KrystianRuszczak/BioSense/hardware/biosense_pcb/README.md

# BioSense PCB

## Main modules
- ESP32 / ESP32-S3
- AD8232 ECG
- GSR input
- MLX90614
- MAX30102
- battery measurement
- buzzer
- push buttons
- WS2812 LEDs

## Firmware pin mapping
See `main/include/biosense_config.hpp`.

## Fabrication
Production files for ordered revisions are stored in `fabrication/revX/`.

## License

Copyright (c) 2026 Krystian Ruszczak.

The hardware design files in this directory are licensed under CERN-OHL-P-2.0. See [LICENSE](LICENSE).

The design files are provided "as is", without warranty. The complete terms are in the license file.
