KrystianRuszczak/BioSense/hardware/biosense_pcb/Biosense.kicad_pcb

## KiCad design hardware/biosense_pcb/Biosense.kicad_pcb (2026-07-09)

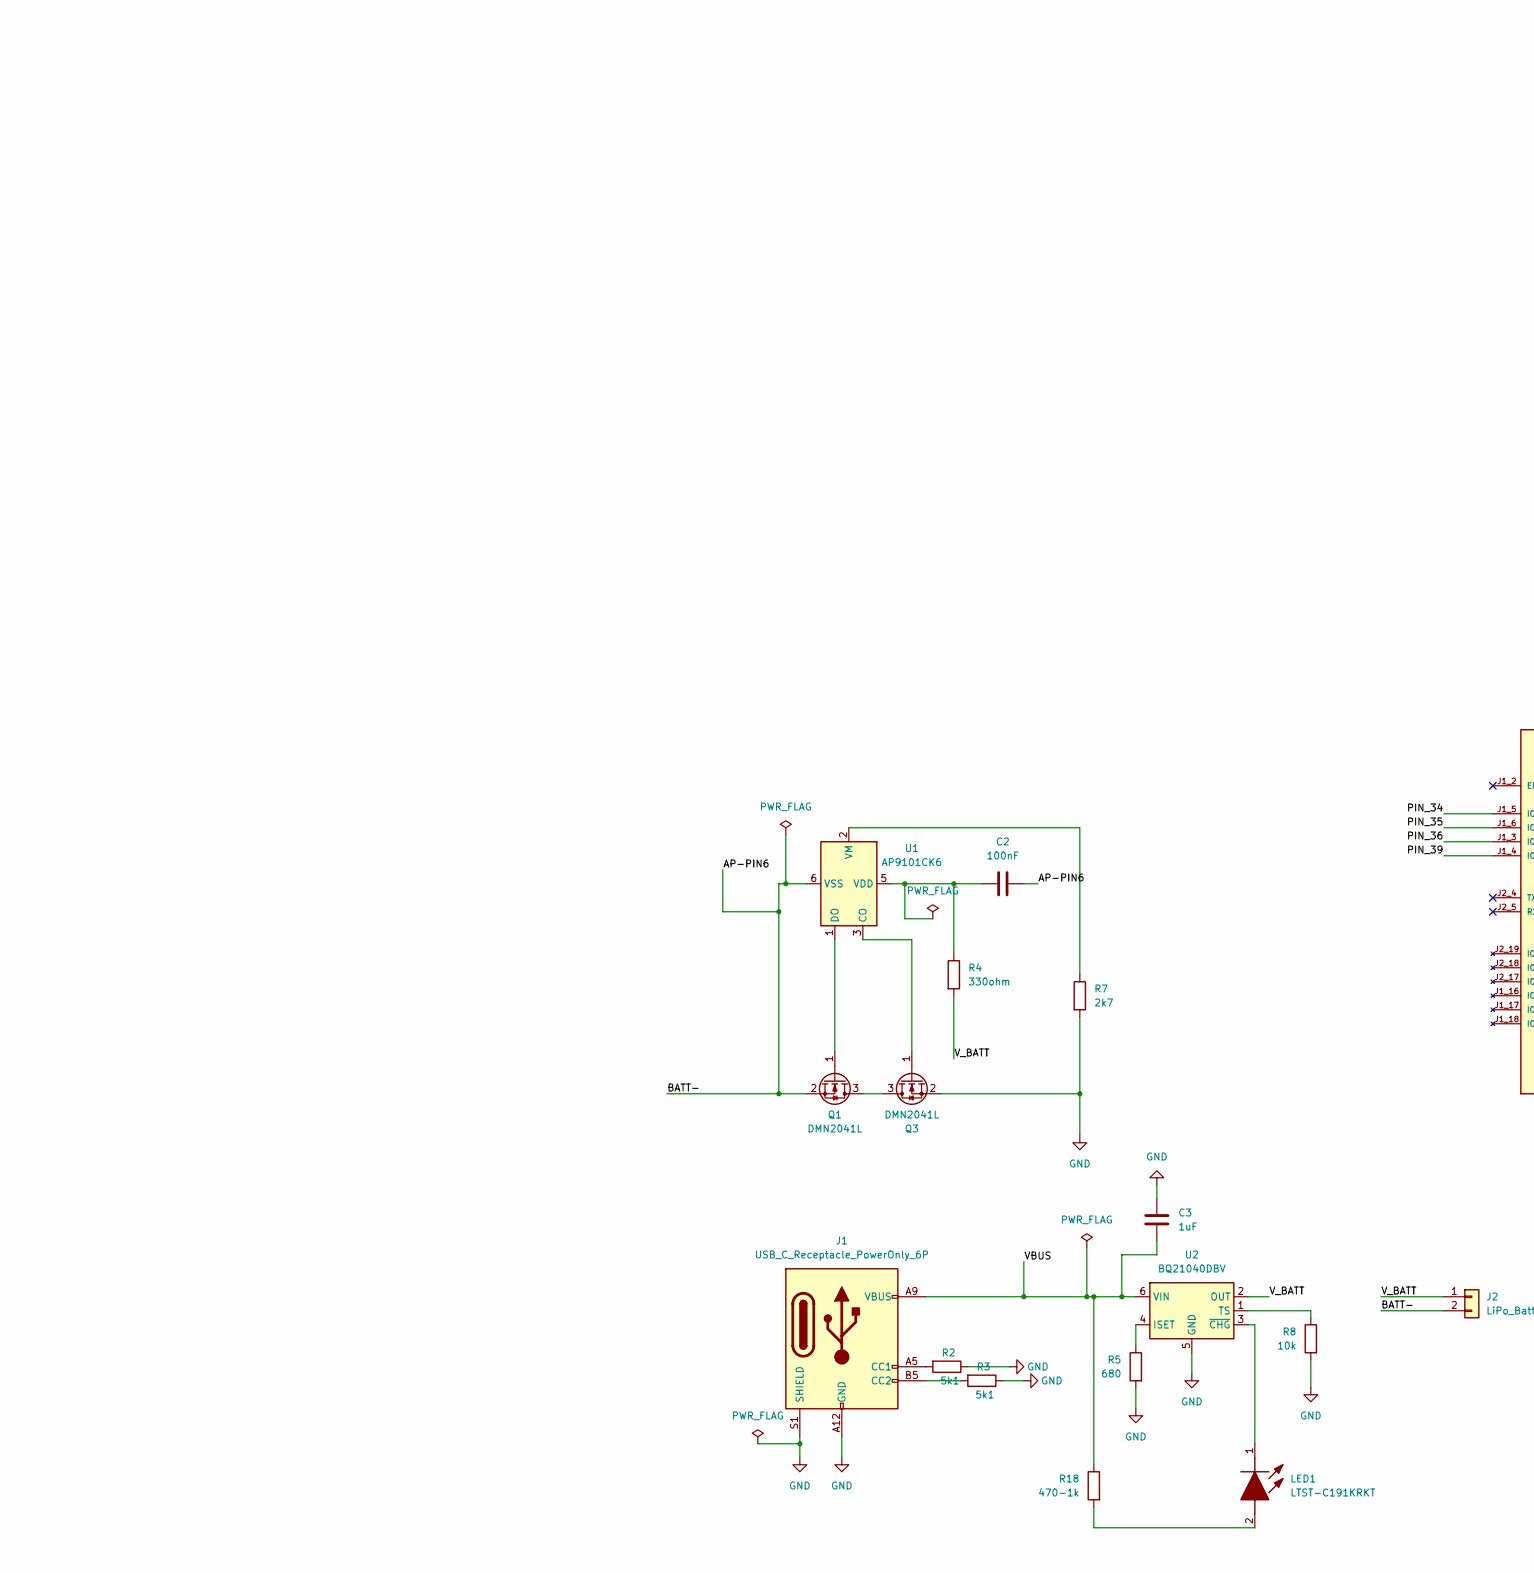
[picture p1: schematic Biosense.kicad_sch, part in row 1, column 1]

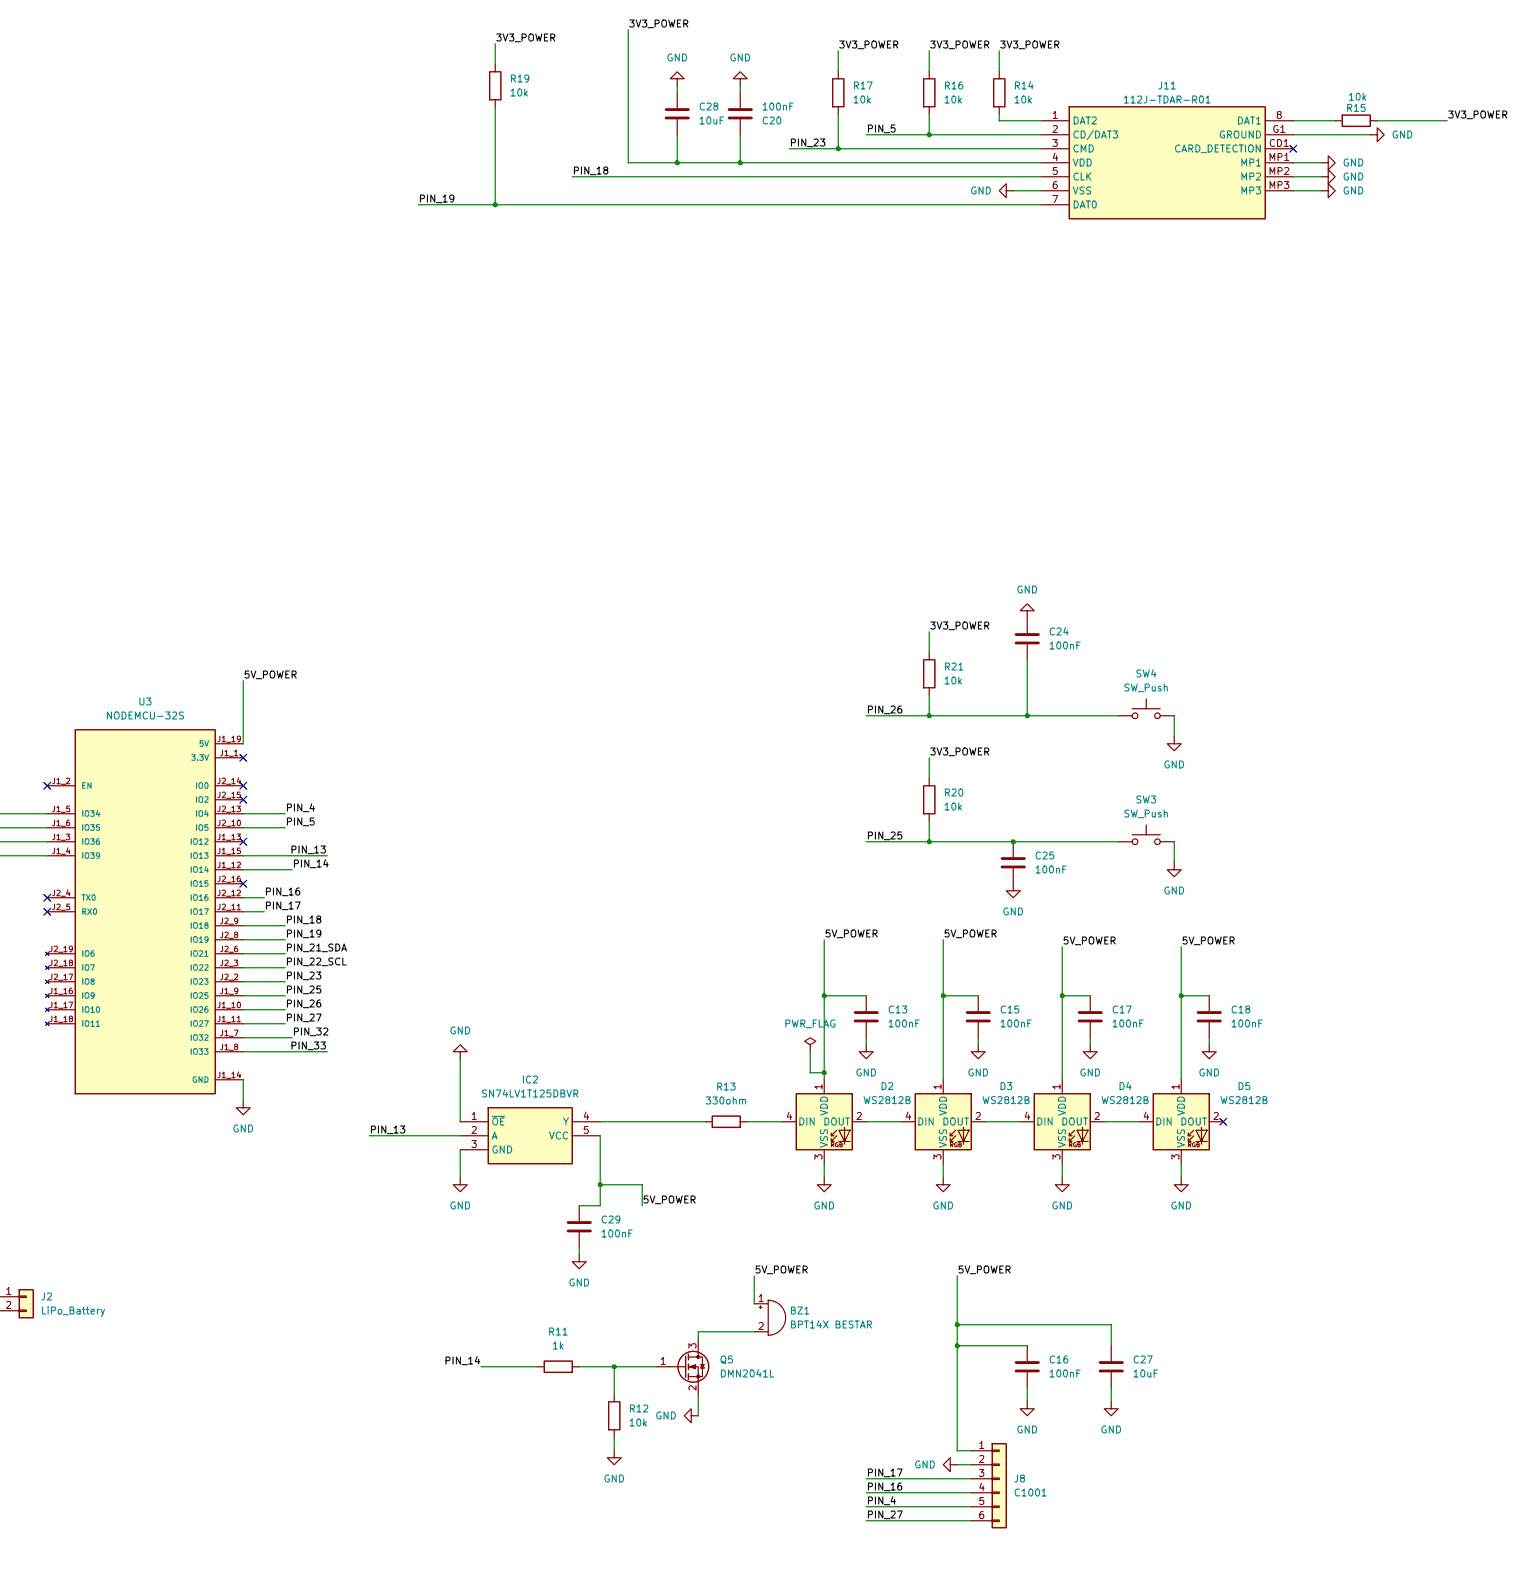
[picture p2: schematic Biosense.kicad_sch, part in row 1, column 2]

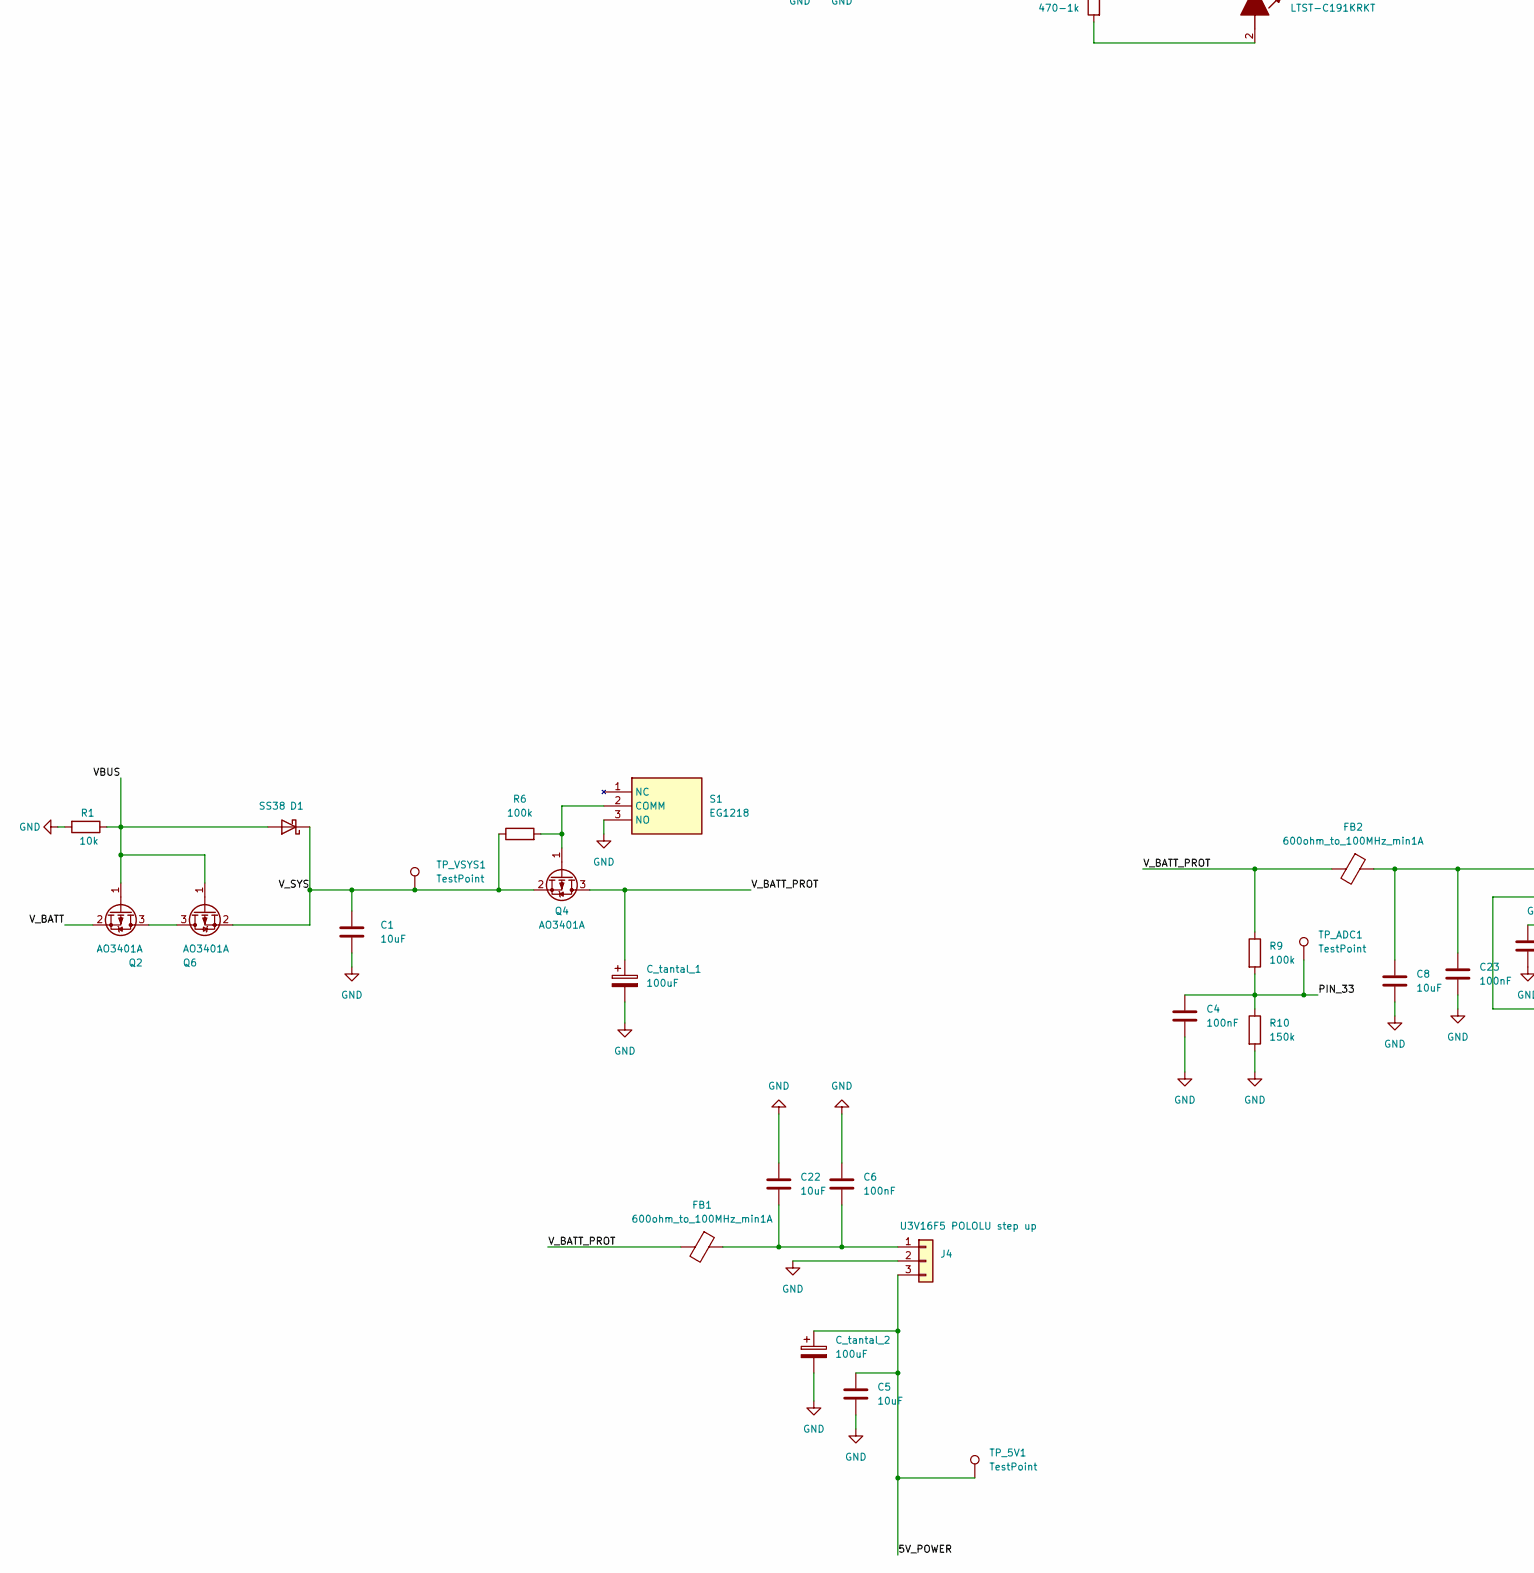
[picture p3: schematic Biosense.kicad_sch, part in row 2, column 1]

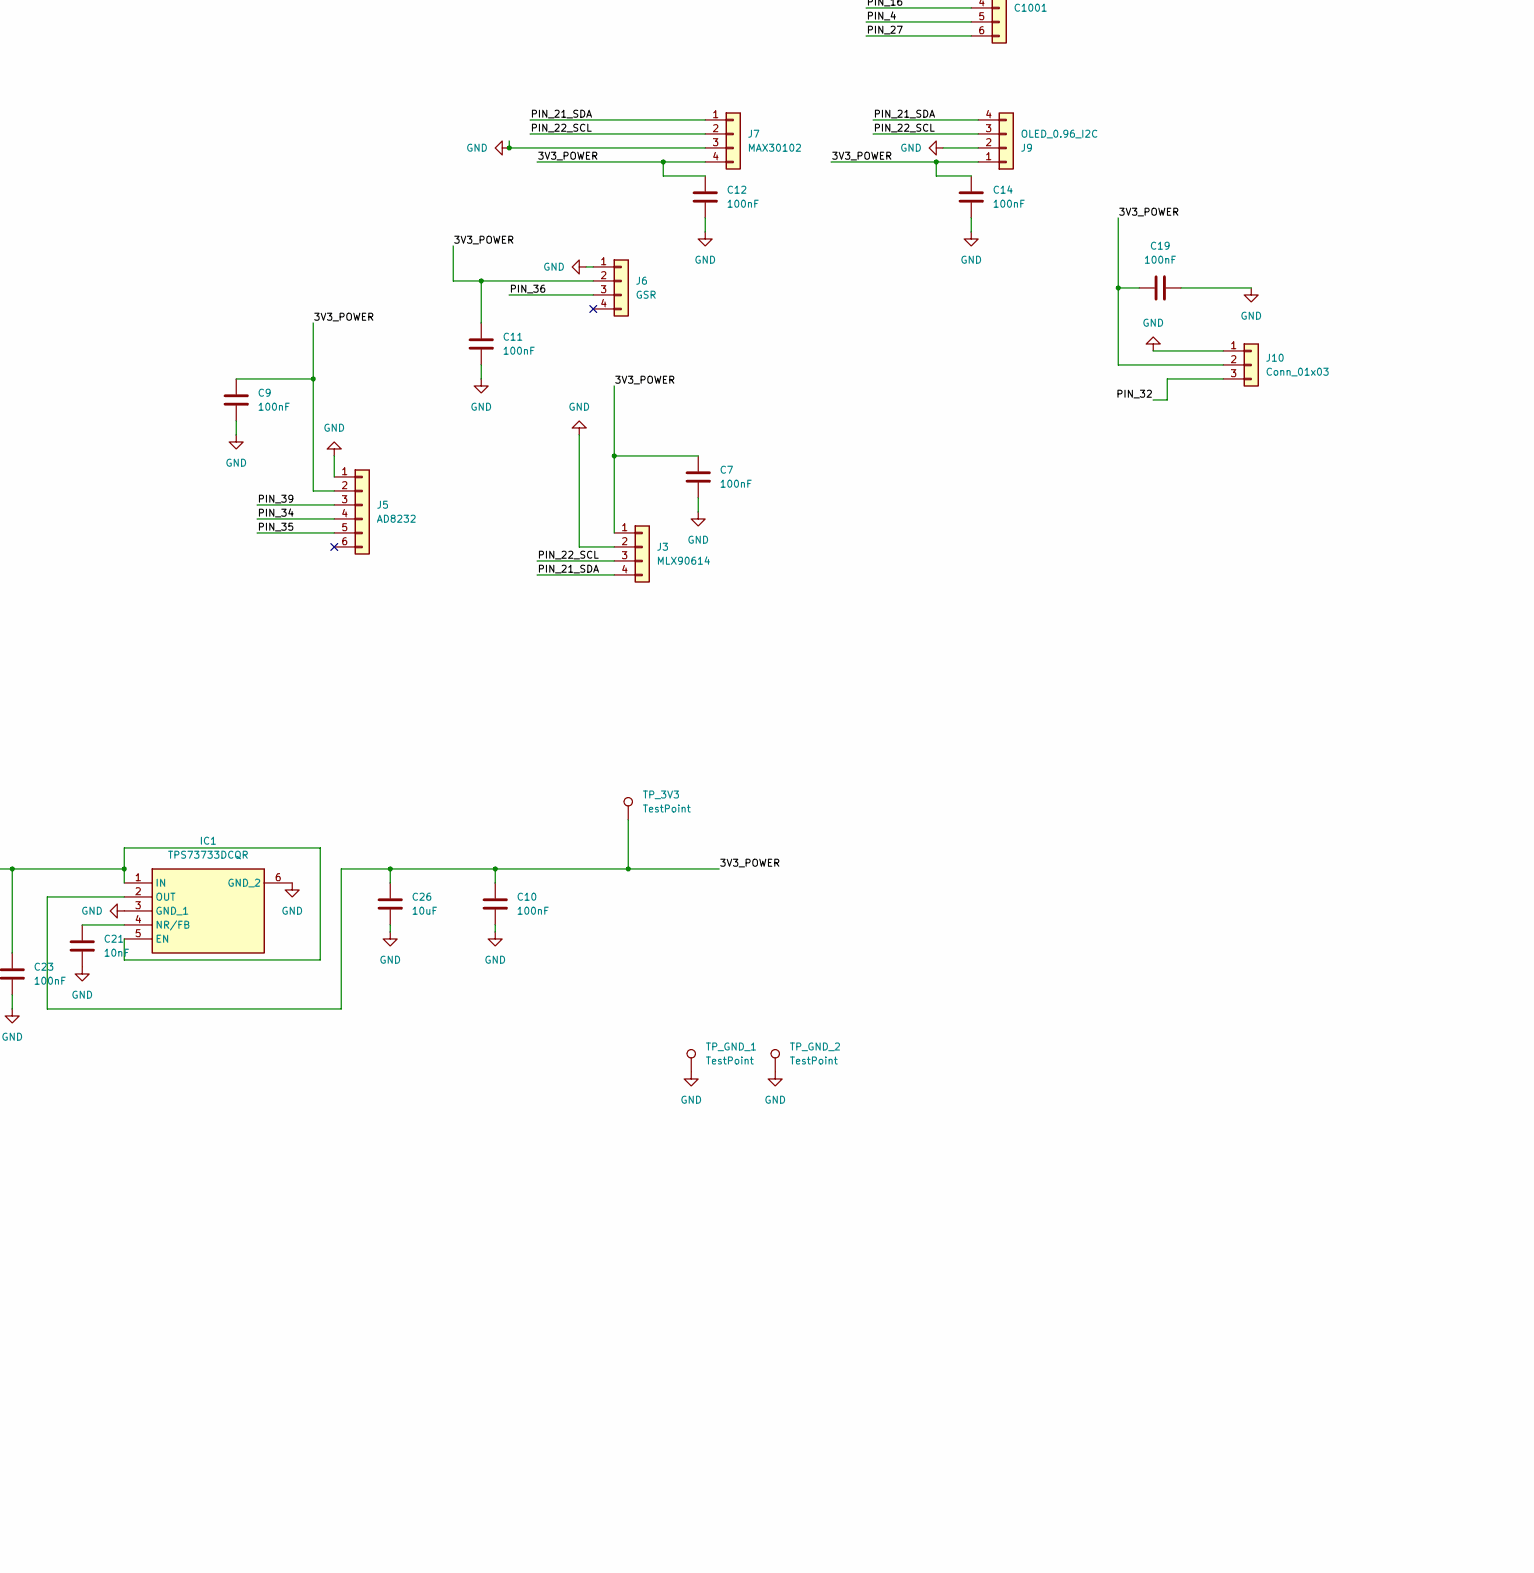
[picture p4: schematic Biosense.kicad_sch, part in row 2, column 2]

Parts:
BZ1: BPT14X BESTAR; Buzzer_15x7.5RM7.6
C1, C5, C8, C22, C26, C27, C28: 10uF; C_0805_2012Metric_Pad1.18x1.45mm_HandSolder
C2, C4, C6, C7, C9, C10, C11, C12, C13, C14, C15, C16, C17, C18, C19, C20, C23, C24, C25, C29: 100nF; C_0805_2012Metric_Pad1.18x1.45mm_HandSolder
C3: 1uF; C_0805_2012Metric_Pad1.18x1.45mm_HandSolder
C21: 10nF; C_0805_2012Metric_Pad1.18x1.45mm_HandSolder
C_tantal_1, C_tantal_2: 100uF; CP_EIA-7343-31_Kemet-D_HandSolder
D1: SS38; D_SMA_Handsoldering
D2, D3, D4, D5: WS2812B; LED_WS2812B_PLCC4_5.0x5.0mm_P3.2mm
FB1, FB2: 600ohm_to_100MHz_min1A; R_0805_2012Metric_Pad1.20x1.40mm_HandSolder
IC1: TPS73733DCQR; SOT127P706X180-6N; Manufacturer_Part_Number TPS73733DCQR
IC2: SN74LV1T125DBVR; SOT-23-5_HandSoldering; Manufacturer_Part_Number SN74LV1T125DBVR
J1: USB_C_Receptacle_PowerOnly_6P; USB_C_Receptacle_GCT_USB4125-xx-x-0190_6P_TopMnt_Horizontal
J2: LiPo_Battery; JST_XH_B2B-XH-A_1x02_P2.50mm_Vertical
J3: MLX90614; PinHeader_1x04_P2.54mm_Vertical
J4: U3V16F5 POLOLU step up; PinSocket_1x03_P2.54mm_Vertical
J5: AD8232; PinHeader_1x06_P2.54mm_Vertical
J6: GSR; PinHeader_1x04_P2.54mm_Vertical
J7: MAX30102; PinHeader_1x04_P2.54mm_Vertical
J8: C1001; PinHeader_1x06_P2.54mm_Vertical
J9: OLED_0.96_I2C; PinHeader_1x04_P2.54mm_Vertical
J10: Conn_01x03; PinHeader_1x03_P2.54mm_Vertical
J11: 112J-TDAR-R01; 112JTDARR01; Manufacturer_Part_Number 112J-TDAR-R01
LED1: LTST-C191KRKT; LEDC1608X55N; Manufacturer_Part_Number LTST-C191KRKT
Q1, Q3, Q5: DMN2041L; SOT-23_Handsoldering
Q2, Q4, Q6: AO3401A; SOT-23_Handsoldering
R1, R8, R12, R14, R15, R16, R17, R19, R20, R21: 10k; R_0805_2012Metric_Pad1.20x1.40mm_HandSolder
R2, R3: 5k1; R_0805_2012Metric_Pad1.20x1.40mm_HandSolder
R4, R13: 330ohm; R_0805_2012Metric_Pad1.20x1.40mm_HandSolder
R5: 680; R_0805_2012Metric_Pad1.20x1.40mm_HandSolder
R6, R9: 100k; R_0805_2012Metric_Pad1.20x1.40mm_HandSolder
R7: 2k7; R_0805_2012Metric_Pad1.20x1.40mm_HandSolder
R10: 150k; R_0805_2012Metric_Pad1.20x1.40mm_HandSolder
R11: 1k; R_0805_2012Metric_Pad1.20x1.40mm_HandSolder
R18: 470-1k; R_0805_2012Metric_Pad1.20x1.40mm_HandSolder
S1: EG1218; Manufacturer_Part_Number EG1218
SW3, SW4: SW_Push; SW_PUSH_6mm
TP_3V3, TP_5V1: TestPoint; TestPoint_Pad_D1.5mm
TP_ADC1: TestPoint; TestPoint_Pad_D1.5mm
TP_GND_1, TP_GND_2: TestPoint; TestPoint_THTPad_D2.0mm_Drill1.0mm
TP_VSYS1: TestPoint; TestPoint_Pad_D1.5mm
U1: AP9101CK6; SOT-23-6_Handsoldering
U2: BQ21040DBV; SOT-23-6_Handsoldering
U3: NODEMCU-32S; MODULE_NODEMCU-32S; PARTREV V1

Connections:
/3V3_POWER: C7.1, C9.1, C10.1, C11.1, C12.1, C14.1, C19.2, C20.1, C26.1, C28.2, IC1.2 (OUT), J3.1, J5.2, J6.2, J7.4, J9.1, J10.2, J11.4 (VDD), R14.1, R15.1, R16.1, R17.1, R19.1, R20.1, R21.1, TP_3V3.1 (1_1)
/5V_POWER: BZ1.1 (+), C5.1, C13.1, C15.1, C16.1, C17.1, C18.1, C27.1, C29.1, C_tantal_2.1, D2.1 (VDD), D3.1 (VDD), D4.1 (VDD), D5.1 (VDD), IC2.5 (VCC), J4.3, J8.1, TP_5V1.1 (1_1), U3.J1_19 (5V)
/AP-PIN6: C2.2, J2.2, Q1.2 (S), U1.6 (VSS)
/PIN_4: J8.5, U3.J2_13 (IO4)
/PIN_5: J11.2 (CD/DAT3), R16.2, U3.J2_10 (IO5)
/PIN_13: IC2.2 (A), U3.J1_15 (IO13)
/PIN_14: R11.1, U3.J1_12 (IO14)
/PIN_16: J8.4, U3.J2_12 (IO16)
/PIN_17: J8.3, U3.J2_11 (IO17)
/PIN_18: J11.5 (CLK), U3.J2_9 (IO18)
/PIN_19: J11.7 (DAT0), R19.2, U3.J2_8 (IO19)
/PIN_21_SDA: J3.4, J7.1, J9.4, U3.J2_6 (IO21)
/PIN_22_SCL: J3.3, J7.2, J9.3, U3.J2_3 (IO22)
/PIN_23: J11.3 (CMD), R17.2, U3.J2_2 (IO23)
/PIN_25: C25.1, R20.2, SW3.1, U3.J1_9 (IO25)
/PIN_26: C24.2, R21.2, SW4.1, U3.J1_10 (IO26)
/PIN_27: J8.6, U3.J1_11 (IO27)
/PIN_32: J10.3, U3.J1_7 (IO32)
/PIN_33: C4.1, R9.2, R10.1, TP_ADC1.1 (1_1), U3.J1_8 (IO33)
/PIN_34: J5.4, U3.J1_5 (IO34)
/PIN_35: J5.5, U3.J1_6 (IO35)
/PIN_36: J6.3, U3.J1_3 (IO36)
/PIN_39: J5.3, U3.J1_4 (IO39)
/VBUS: C3.2, D1.2 (A), J1.A9 (VBUS), J1.B9 (VBUS), Q2.1 (G), Q6.1 (G), R1.1, R18.1, U2.6 (VIN)
/V_BATT: J2.1, Q2.2 (S), R4.2, U2.2 (OUT)
/V_BATT_PROT: C_tantal_1.1, FB1.2, FB2.2, Q4.3 (D), R9.1
/V_SYS: C1.1, D1.1 (K), Q4.2 (S), Q6.2 (S), R6.1, TP_VSYS1.1 (1_1)
GND: C1.2, C3.1, C4.2, C5.2, C6.1, C7.2, C8.2, C9.2, C10.2, C11.2, C12.2, C13.2, C14.2, C15.2, C16.2, C17.2, C18.2, C19.1, C20.2, C21.1, C22.1, C23.2, C24.1, C25.2, C26.2, C27.2, C28.1, C29.2, C_tantal_1.2, C_tantal_2.2, D2.3 (VSS), D3.3 (VSS), D4.3 (VSS), D5.3 (VSS), IC1.3 (GND_1), IC1.6 (GND_2), IC2.1 (~OE), IC2.3 (GND), J1.A12 (GND), J1.B12 (GND), J1.S1 (SHIELD), J3.2, J4.2, J5.1, J6.1, J7.3, J8.2, J9.2, J10.1, J11.6 (VSS), J11.G1 (GROUND), J11.MP1, J11.MP2, J11.MP3, Q3.2 (S), Q5.2 (S), R1.2, R2.1, R3.1, R5.2, R7.2, R8.2, R10.2, R12.2, S1.3 (NO), SW3.2, SW4.2, TP_GND_1.1 (1_1), TP_GND_2.1 (1_1), U2.5 (GND), U3.J1_14 (GND), U3.J2_1 (GND), U3.J2_7 (GND)
unnamed: BZ1.2 (-), Q5.3 (D)
unnamed: D2.4 (DIN), R13.2
unnamed: D2.2 (DOUT), D3.4 (DIN)
unnamed: D3.2 (DOUT), D4.4 (DIN)
unnamed: D4.2 (DOUT), D5.4 (DIN)
unnamed: C8.1, C23.1, FB2.1, IC1.1 (IN), IC1.5 (EN)
unnamed: C21.2, IC1.4 (NR/FB)
unnamed: IC2.4 (Y), R13.1
unnamed: J1.A5 (CC1), R2.2
unnamed: J1.B5 (CC2), R3.2
unnamed: C6.2, C22.2, FB1.1, J4.1
unnamed: J11.8 (DAT1), R15.2
unnamed: J11.1 (DAT2), R14.2
unnamed: LED1.2 (A), R18.2
unnamed: LED1.1 (K), U2.3 (~CHG)
unnamed: Q1.3 (D), Q3.3 (D)
unnamed: Q1.1 (G), U1.1 (DO)
unnamed: Q2.3 (D), Q6.3 (D)
unnamed: Q3.1 (G), U1.3 (CO)
unnamed: Q4.1 (G), R6.2, S1.2 (COMM)
unnamed: Q5.1 (G), R11.2, R12.1
unnamed: C2.1, R4.1, U1.5 (VDD)
unnamed: R7.1, U1.2 (VM)
unnamed: R5.1, U2.4 (ISET)
unnamed: R8.1, U2.1 (TS)

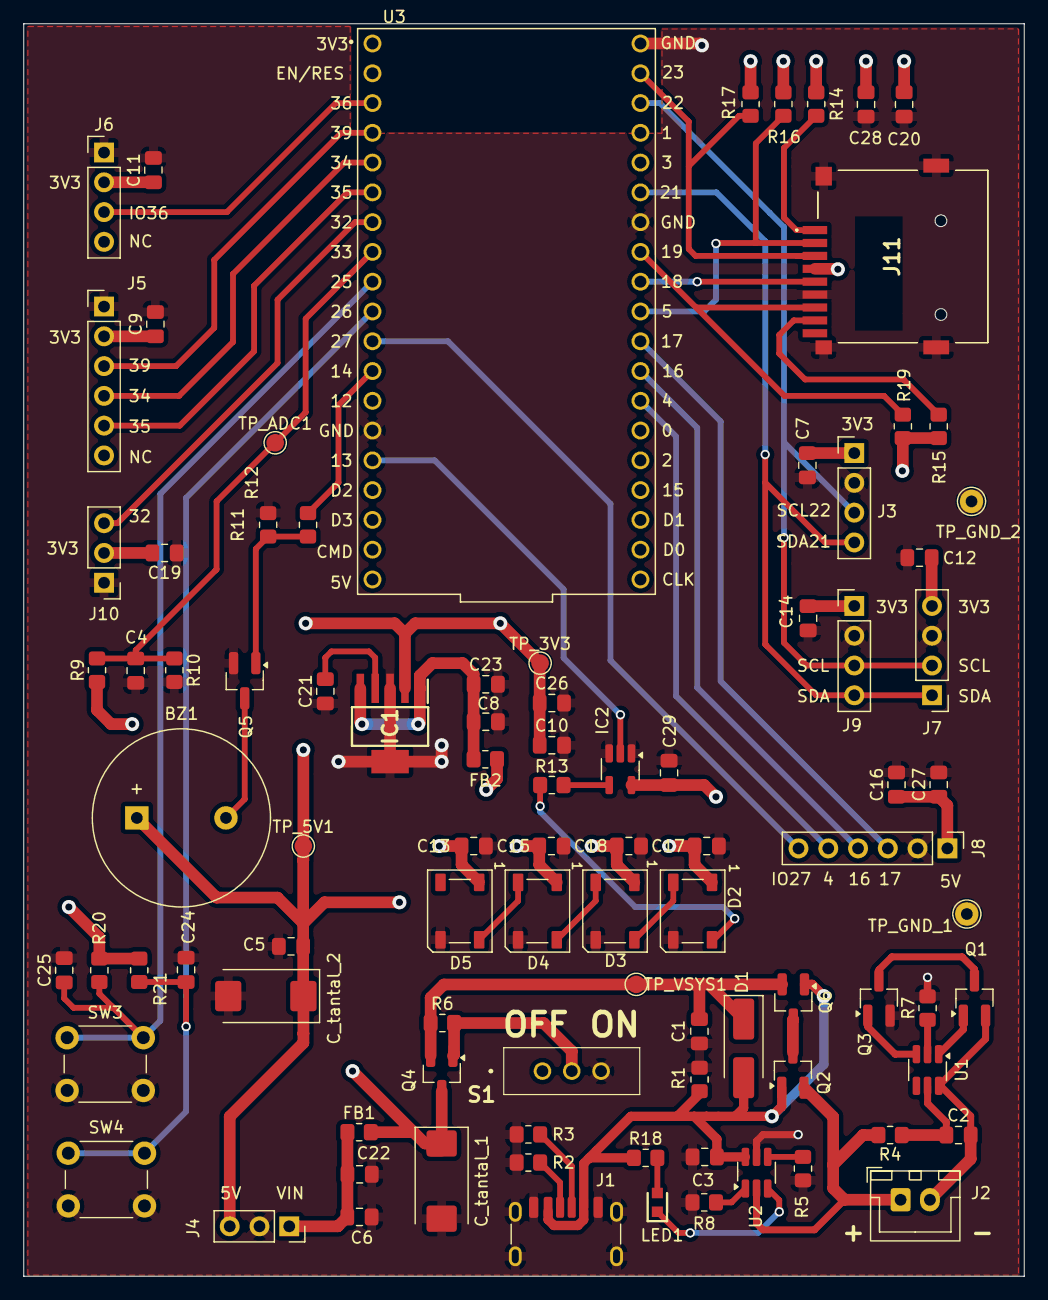
[picture p5: board Biosense.kicad_pcb from above]

Board: 4 copper layers, 85.3 x 106.8 mm, 92 parts (0 on the bottom side), 53 nets.
