KrystianRuszczak/BioSense/main/include/biosense_config.hpp

#pragma once

// PINS

#define PIN_GSR 36

#define PIN_ECG_OUT 39
#define PIN_LO_PLUS 35
#define PIN_LO_MINUS 34

// I2C PARAMETERS
#define I2C_SDA 21
#define I2C_SCL 22
#define I2C_MASTER_FREQ_HZ 100000

#define PIN_BATT 33
#define PIN_BUZZER 14

#define PIN_BUTTON_A 25
#define PIN_BUTTON_B 26

#define PIN_LEDS 13
#define NUM_LEDS 4

// ECG PARAMETERS

#define ECG_SAMPLE_RATE_HZ 250 
#define ECG_LPF_ALPHA 0.25f
#define ECG_RPEAK_THRESHOLD_RATIO 0.65f
#define ECG_RPEAK_REFRACTORY_MS 300
// #define SAMPLE_INTERVAL (1000000UL / SAMPLE_RATE_HZ)

// GSR PARAMETERS   

#define GSR_SAMPLE_RATE_HZ 10
#define GSR_SAMPLE_INTERVAL_SAMPLES (ECG_SAMPLE_RATE_HZ / GSR_SAMPLE_RATE_HZ)

static_assert(
    ECG_SAMPLE_RATE_HZ % GSR_SAMPLE_RATE_HZ == 0,
    "ECG sample rate must be divisible by GSR sample rate"
);

// UDP PARAMETERS

#define UDP_BATCH_SIZE 5
#define UDP_BUFFER_SIZE 1024

// MAX30102 PARAMETERS

#define MAX301_SAMPLE_RATE_HZ 100
#define MAX301_SPO2_BUFFER_SIZE 100
