KrystianRuszczak/BioSense/(commit log)

2026-07-09 Repository update
    [bio-sense-guard V6.1b.kicad_pcb, bio-sense-guard V6.1b.kicad_sch]
2026-07-24 Update repository
    [Biosense.kicad_pcb, Biosense.kicad_sch]
